flaviobattimo/rover-esp8266/assets/UNO+WiFi-R3-AT328-ESP8266-CH340G.jpg

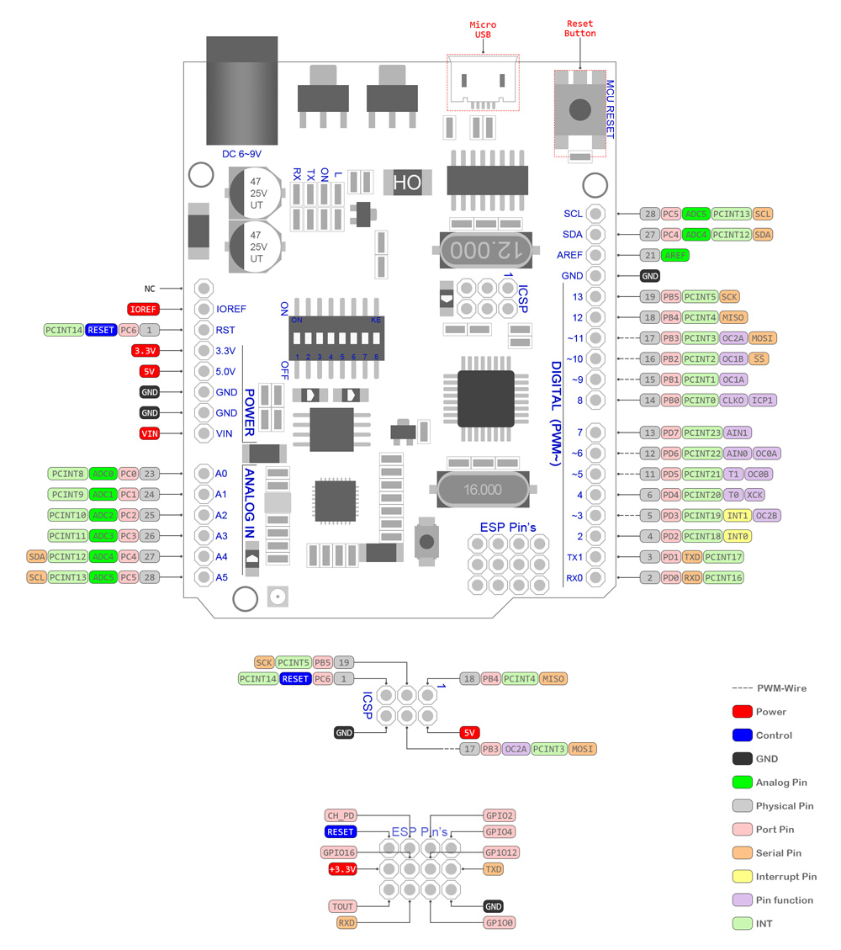
assets/UNO+WiFi-R3-AT328-ESP8266-CH340G.jpg
