flaviobattimo/rover-esp8266/data/Rover.png

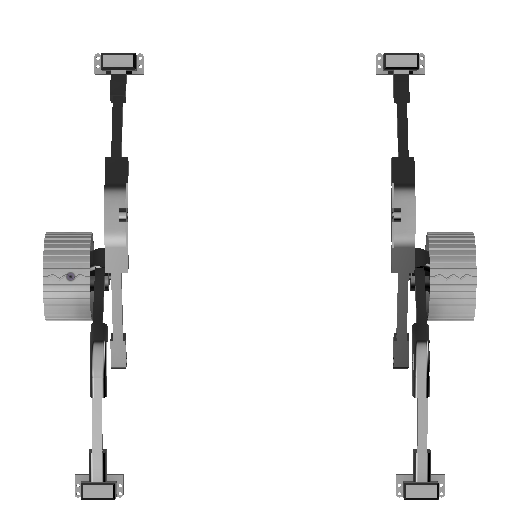
data/Rover.png
