flaviobattimo/rover-esp8266/data/Wheel.png

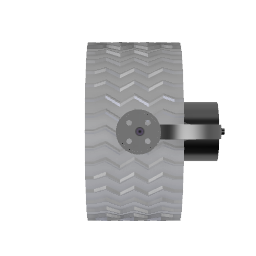
data/Wheel.png
