flaviobattimo/rover-esp8266/docs/atmega32p-esp8266-switch.png

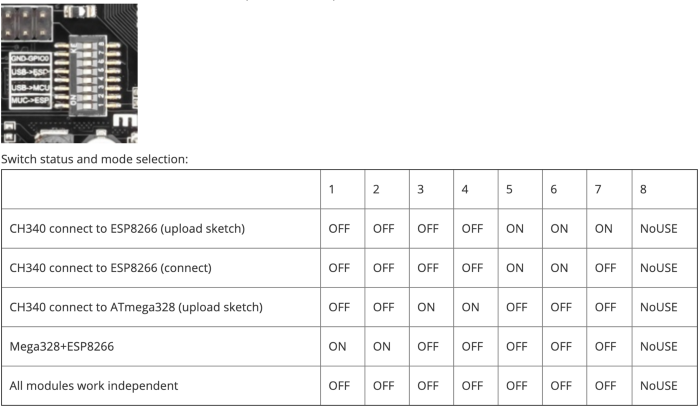
docs/atmega32p-esp8266-switch.png
